antmicro/arty-mpw-tester/doc/arty-mpw-tester.md

# Arty MPW tester

```{image} ../img/arty-mpw-tester.png
:width: 700px
:align: center
```
&nbsp;

The Arty MPW tester is simple expansion board compatible with Digilent Arty A7 development kit. This board connects IO signals from the Xilinx Artix FPGA located on the Arty board to an open hardware Caravel breakout board. The Caravel breakout board allows testing ASIC designs prepared for Multi Project Wafer (MPW) shuttles and fabricated with one of the available open Process Design Kits (PDKs).

The hardware is open and can be found on GitHub:
<https://github.com/antmicro/arty-mpw-tester/>

The following instructions explain how to set up the board for MPW testing.

## Arty MPW tester configuration

Arty MPW tester was designed to give user flexibility in configuration of the tester.\
User can independently configure:

- Power
- FTDI to MPRJ UART connection (enable/disable)
- Source for Caravel-breakout XCLK (internal oscillator / Arty IO42 pin)
- Internal XCLK source (enable/disable)

### Power

The Arty MPW tester can be supplied either from Arty or USB connector.

```{note}
Both power sources are always connected to the dual LDO via protection diodes.
```

#### Fixed/dynamic LDO selection

The Arty MPW tester features dual LDO supplying 1.8V and 3.3V rails.
Each rail can be set to either:

- `FIXED` - supplying fixed 1.8V or 3.3V depending on rail
- `DYNAMIC` - allowing user set LDO voltage using I2C digipot

I2C digipot (`MCP4661-103E/ML`) is used to dynamically adjust 1.8V and 3.3V rail voltages.\
Placing jumper on position `FIXED` on either 1.8V and/or 3.3V rail bypasses digipot and forces LDO into fixed voltage regulation on given rail.

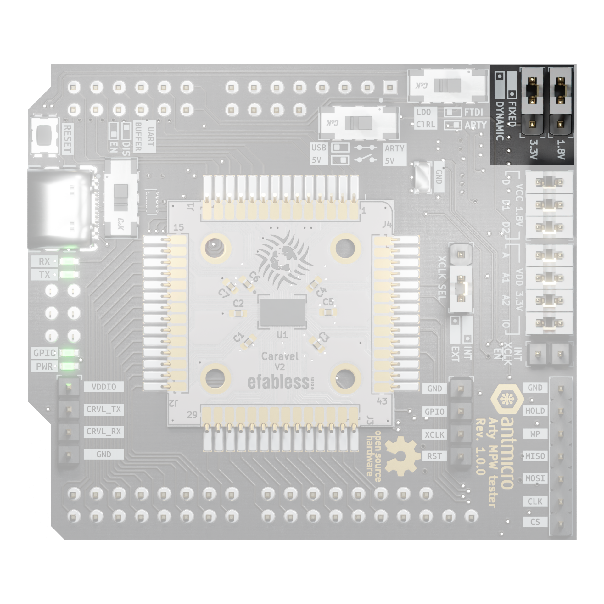
[picture p2: img/arty-mpw-tester-ldo-mode.png]
```{image} ../img/arty-mpw-tester-ldo-mode.png
:width: 500px
:align: center
```

#### Rail EN control

Both 3.3V and 1.8V rails can be enabled separately using `EN1` and `EN2` pins of the LDO.\
`LDO CTRL` switch can be set in two positions:
- `ARTY` - connects the Arty A7 board to the `EN1/2` pins of the dual LDO
- `FTDI` - connects the FTDI to the `EN1/2` pins of the dual LDO

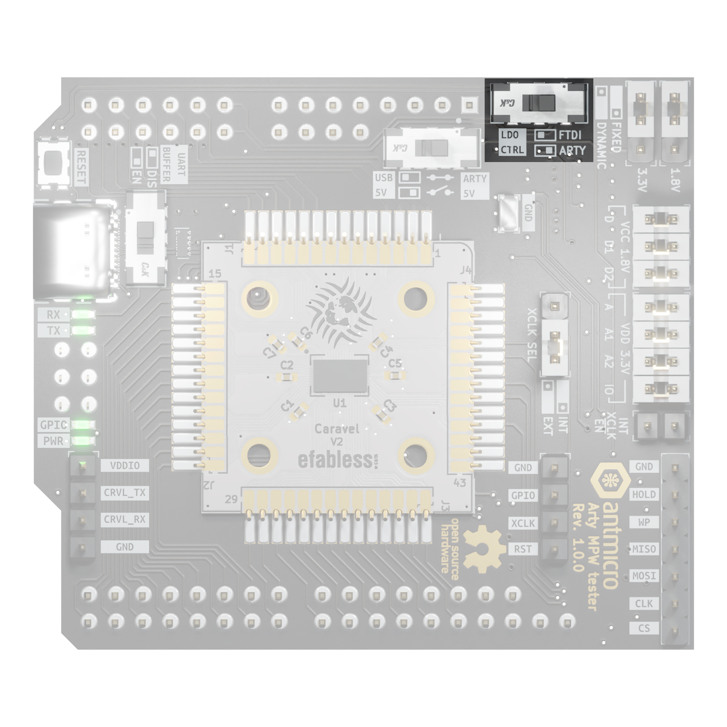
[picture p3: img/arty-mpw-tester-power-ctrl-selector.png]
```{image} ../img/arty-mpw-tester-power-ctrl-selector.png
:width: 500px
:align: center
```

#### Individual rail connections

Each of the power rails routed on Caravel breakout is exposed on `1x2 2.54mm` pin header allowing for selecting which rails are enabled.\
Using this header it is also possible to manually inject voltage into separate rails

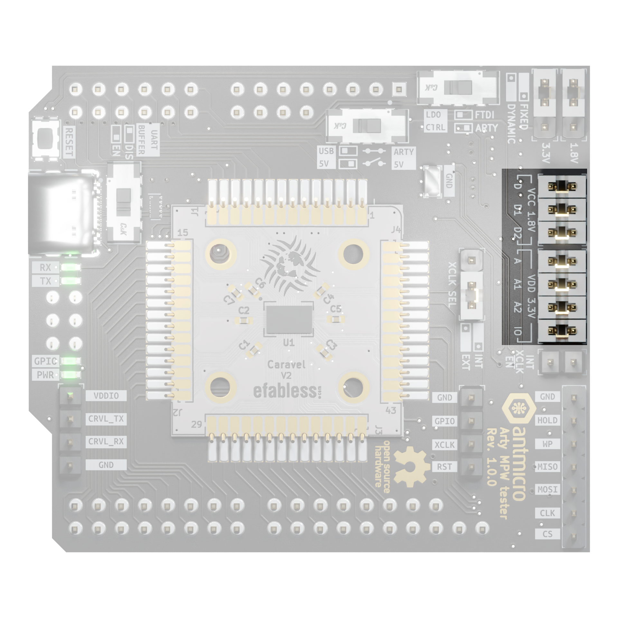
[picture p4: img/arty-mpw-tester-power-rails.png]
 ```{image} ../img/arty-mpw-tester-power-rails.png
:width: 500px
:align: center
```

#### Arty / USB rail connection
```{warning}
This feature should be used only to supply Arty from Arty MPW tester.
```
Switch allowing connection of the 5V USB and 5V Arty rails can be set in two positions:
- `OPEN` - USB 5V and Arty 5V rails are separated
- `CLOSED` - USB 5V and Arty 5V rails are connected, allowing to supply Arty from Arty MPW tester 

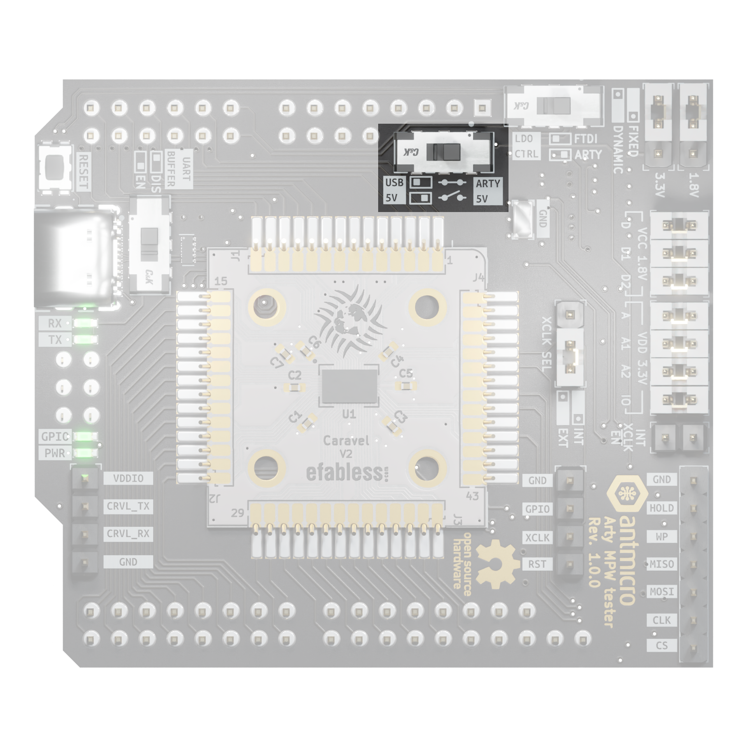
[picture p5: img/arty-mpw-tester-arty-usb-rail-switch.png]
```{image} ../img/arty-mpw-tester-arty-usb-rail-switch.png
:width: 500px
:align: center
```

### USB UART

FTDI used in design (FT230H) can be used in UART and MPSSE mode. By default UART buffers are controlled by FTDI. User can select, by setting `UART BUFFER` switch to either:
- `DIS` - control over UART buffers is retained by FTDI  
- `EN` - forces UART buffers to be enabled

```{note}
For MPSSE mode `UART BUFFER` slide switch should be set to `DIS`.
```

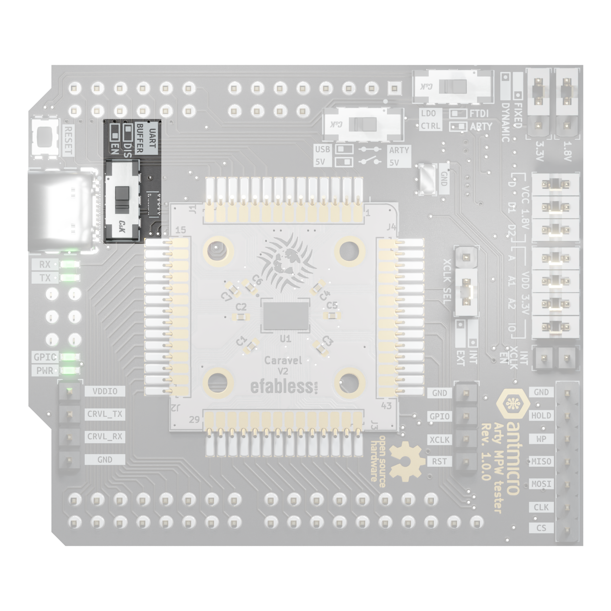
[picture p6: img/arty-mpw-tester-uart-buffer-switch.png]
```{image} ../img/arty-mpw-tester-uart-buffer-switch.png
:width: 500px
:align: center
```

### XCLK

Clock supplied to the Caravel breakout can be sourced in two ways.\
Using `XCLK SEL` header user can switch between:
- `INT` - sourcing XCLK from onboard oscillator
- `EXT` - sourcing XCLK from Arty IO42 pin

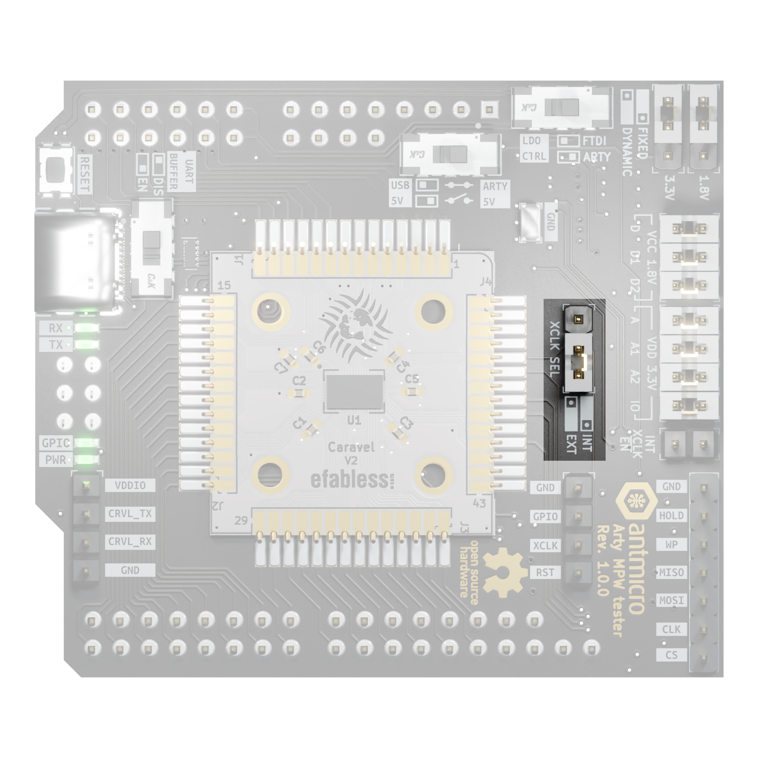
[picture p7: img/arty-mpw-tester-xclk-source-selection.png]
```{image} ../img/arty-mpw-tester-xclk-source-selection.png
:width: 500px
:align: center
```

When `XCLK SEL` is set to `INT` user can enable and disable onboard oscillator using `INT XCLK EN` header:

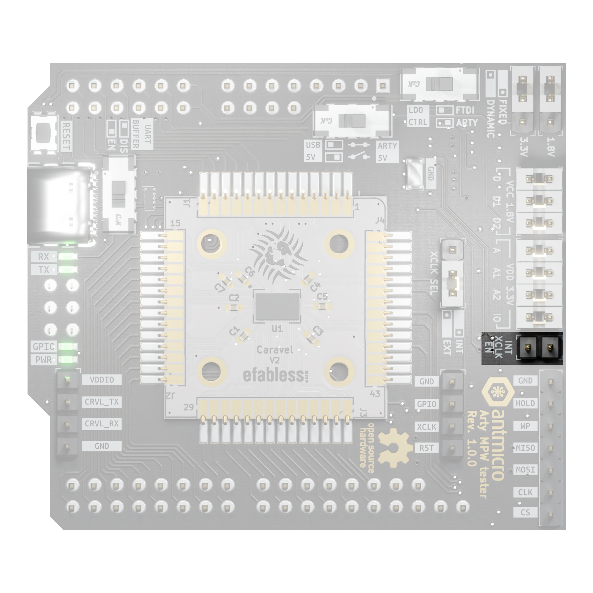
[picture p8: img/arty-mpw-tester-internal-oscillator-ctrl.png]
```{image} ../img/arty-mpw-tester-internal-oscillator-ctrl.png
:width: 500px
:align: center
```

## Default configuration

Before plugging USB to Arty MPW Tester or Arty board make sure that configuration jumpers and switches are set correctly.

Default configuration for the Arty MPW tester is as follows:

| Setting | Slide switch  | Jumper |
|---|---|---|
| 1.8V LDO 	 | 	 | Fixed |
| 3.3V LDO 	 | 	 | Fixed |
| LDO CTRL 	 | ARTY  	 | |
| VCC 1.8V D  	 | 	 | YES |
| VCC 1.8V D1 	 | 	 | YES |
| VCC 1.8V D2 	 | 	 | YES |
| VDD 3.3V A  	 | 	 | YES |
| VDD 3.3V A1 	 | 	 | YES |
| VDD 3.3V A2 	 | 	 | YES |
| VDD 3.3V IO 	 | 	 | YES |
| IN XCLK EN  	 | 	 | NO |
| XCLK SEL 	 | 	 | EXT |
| UART BUFFER 	 | DIS 	 | |
| Arty 5V - USB 5V  | OPEN | |

Picture below presents default configuration for slide switches and jumpers

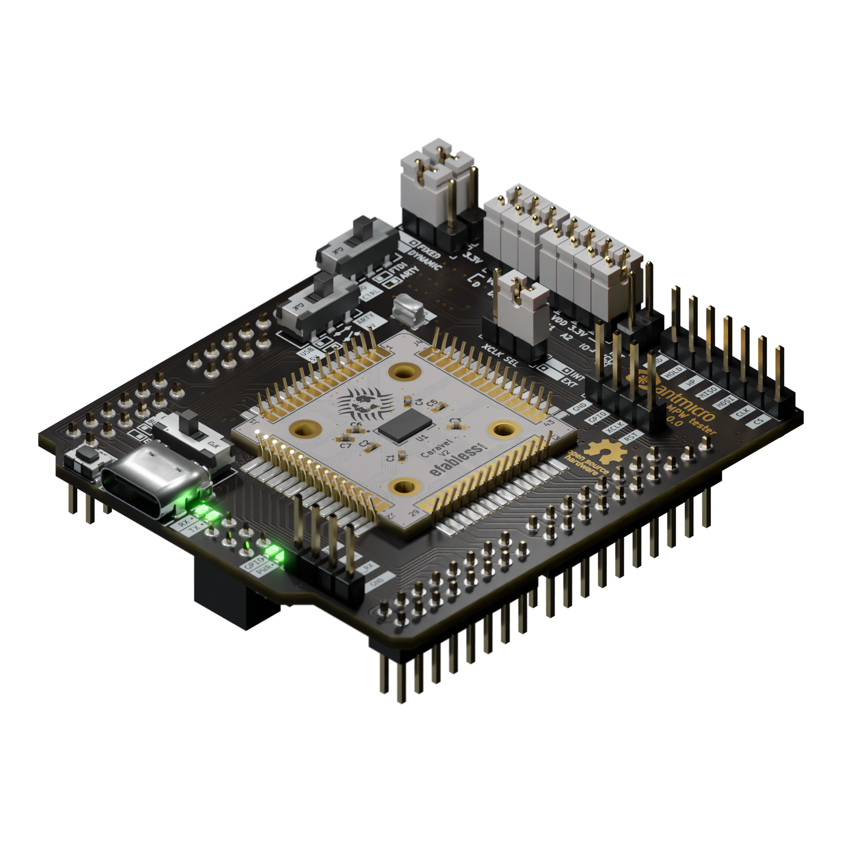
[picture p9: img/arty-mpw-tester-default-configuration.png]
```{image} ../img/arty-mpw-tester-default-configuration.png
:width: 500px
:align: center
```

## Pinouts

### Caravel - Arty interface

| Caravel breakout 	| FPGA Pin 	| ChipKit pin 	| Dedicated function|
|---	|---	|---	|---	|
| IO00 	| R18 	| IO39 	| 	|
| IO01 	| P17 	| IO13 	| SPI MISO 	|
| IO02 	| T18 	| IO38 	| SPI MOSI 	|
| IO03 	| R17 	| IO12 	| SPI CS 	|
| IO04 	| U17 	| IO37 	| SPI  SCK 	|
| IO05 	| U18 	| IO11 	| Caravel RX 	|
| IO06 	| N14 	| IO36 	| Caravel TX 	|
| IO07 	| V17 	| IO10 	| 	|
| IO08 	| N16 	| IO35 	| 	|
| IO09 	| M16 	| IO09 	| 	|
| IO10 	| R16 	| IO34 	| 	|
| IO11 	| N15 	| IO08 	| 	|
| IO12 	| P15 	| IO33 	| 	|
| IO13 	| T16 	| IO07 	| 	|
| IO14 	| R15 	| IO32 	| 	|
| IO15 	| T15 	| IO06 	| 	|
| IO16 	| R13 	| IO31 	| 	|
| IO17 	| T14 	| IO05 	| 	|
| IO18 	| R11 	| IO30 	| 	|
| IO19 	| R12 	| IO04 	| 	|
| IO20 	| R10 	| IO29 	| 	|
| IO21 	| T11 	| IO03 	| 	|
| IO22 	| M13 	| IO28 	| 	|
| IO23 	| P14 	| IO02 	| 	|
| IO24 	| V16 	| IO27 	| 	|
| IO25 	| U16 	| IO01 	| 	|
| IO26 	| U11 	| IO26 	| 	|
| IO27 	| V15 	| IO00 	| 	|
| IO28 	| A3 	| A11 	| 	|
| IO29 	| D5 	| A5 	| 	|
| IO30 	| A4 	| A10 	| 	|
| IO31 	| D7 	| A4 	| 	|
| IO32 	| E5 	| A9 	| 	|
| IO33 	| E7 	| A3 	| 	|
| IO34 	| E6 	| A8 	| 	|
| IO35 	| C7 	| A2 	| 	|
| IO36 	| B6 	| A7 	| 	|
| IO37 	| D8 	| A1 	| 	|
| GPIO 	| M17 	| IO42 	| 	|
| FLASH SO 	| G1 	| MISO 	| 	|
| FLASH SCK 	| F1 	| SCK 	| 	|
| FLASH SI 	| H1 	| MOSI 	| 	|
| FLASH CS 	| C1 	| SS 	| 	|

### Caravel - FTDI interface

| Caravel breakout 	| FTDI 	|
|---	|---	|
| IO01 	| ADBUS2 	|
| IO02 	| ADBUS1 	|
| IO03 	| ADBUS3 	|
| IO04 	| ADBUS0 	|
| IO05 	| ADBUS0 (via buffer) 	|
| IO06 	| ADBUS1 (via buffer) 	|

### Control pins

| Function 	| FTDI 	| FPGA Pin 	| ChipKit pin 	|
|---	|---	|---	|---	|
| LDO EN1 (3.3V) | ACBUS5 	| F5 	| A0 	|
| LDO EN2 (1.8V) 	| ACBUS6 	| B7 	| A6 	|
| Caravel RESET 	| ACBUS1 	| N17 	| IO41 	|
| UART buff EN  	| ACBUS0 	| - 	| - 	|
| XLCK 	| - 	| P18 	| IO40 	|
| DIGIPOT SCL 	| - 	| L18 	| SCL 	|
| DIGIPOT SDA 	| - 	| M18 	| SDA 	|

### MPRJ UART header 

<table>
<tr><td>

| Pin 	| Signal |
|---- |--- |
| 1 | VDDIO |
| 2 | Caravel TX |
| 3 | Caravel RX |
| 4 | GND |

</td><td>

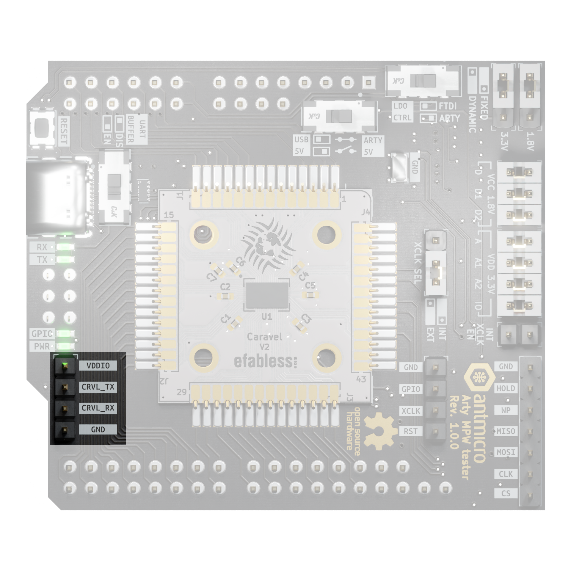
[picture p10: img/arty-mpw-tester-mprj-uart.png]
```{image} ../img/arty-mpw-tester-mprj-uart.png
:width: 400px
:align: center
```

</td></tr> </table>

### SPI flash and Caravel MGMT headers

<table><tr>
<td>

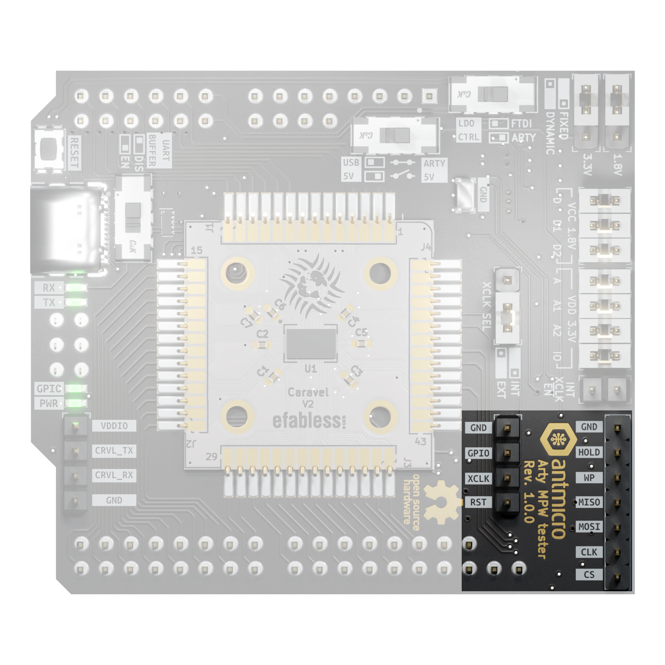
[picture p11: img/arty-mpw-tester-mgmt-headers.png]
```{image} ../img/arty-mpw-tester-mgmt-headers.png
:width: 400px
:align: center
```

</td>
<td>

| Pin 	| Signal  | 
|-----  | ---  |
| 1 |  GND	  | 
| 2 |  GPIO	  | 
| 3 |  XCLK	  | 
| 4 |  RESET  | 

</td>
<td>

| Pin 	| Signal  |
|-----  | ---  |
| 1 |  CS	  |
| 2 |  CLK	  |
| 3 |  MOSI	  |
| 4 |  MISO	  |
| 5 |  CLK	  |
| 6 |  GND	  |

</td>
</tr> </table>
