antmicro/arty-mpw-tester/arty-mpw-tester.kicad_pcb

## KiCad design arty-mpw-tester.kicad_pcb (2022-12-14)

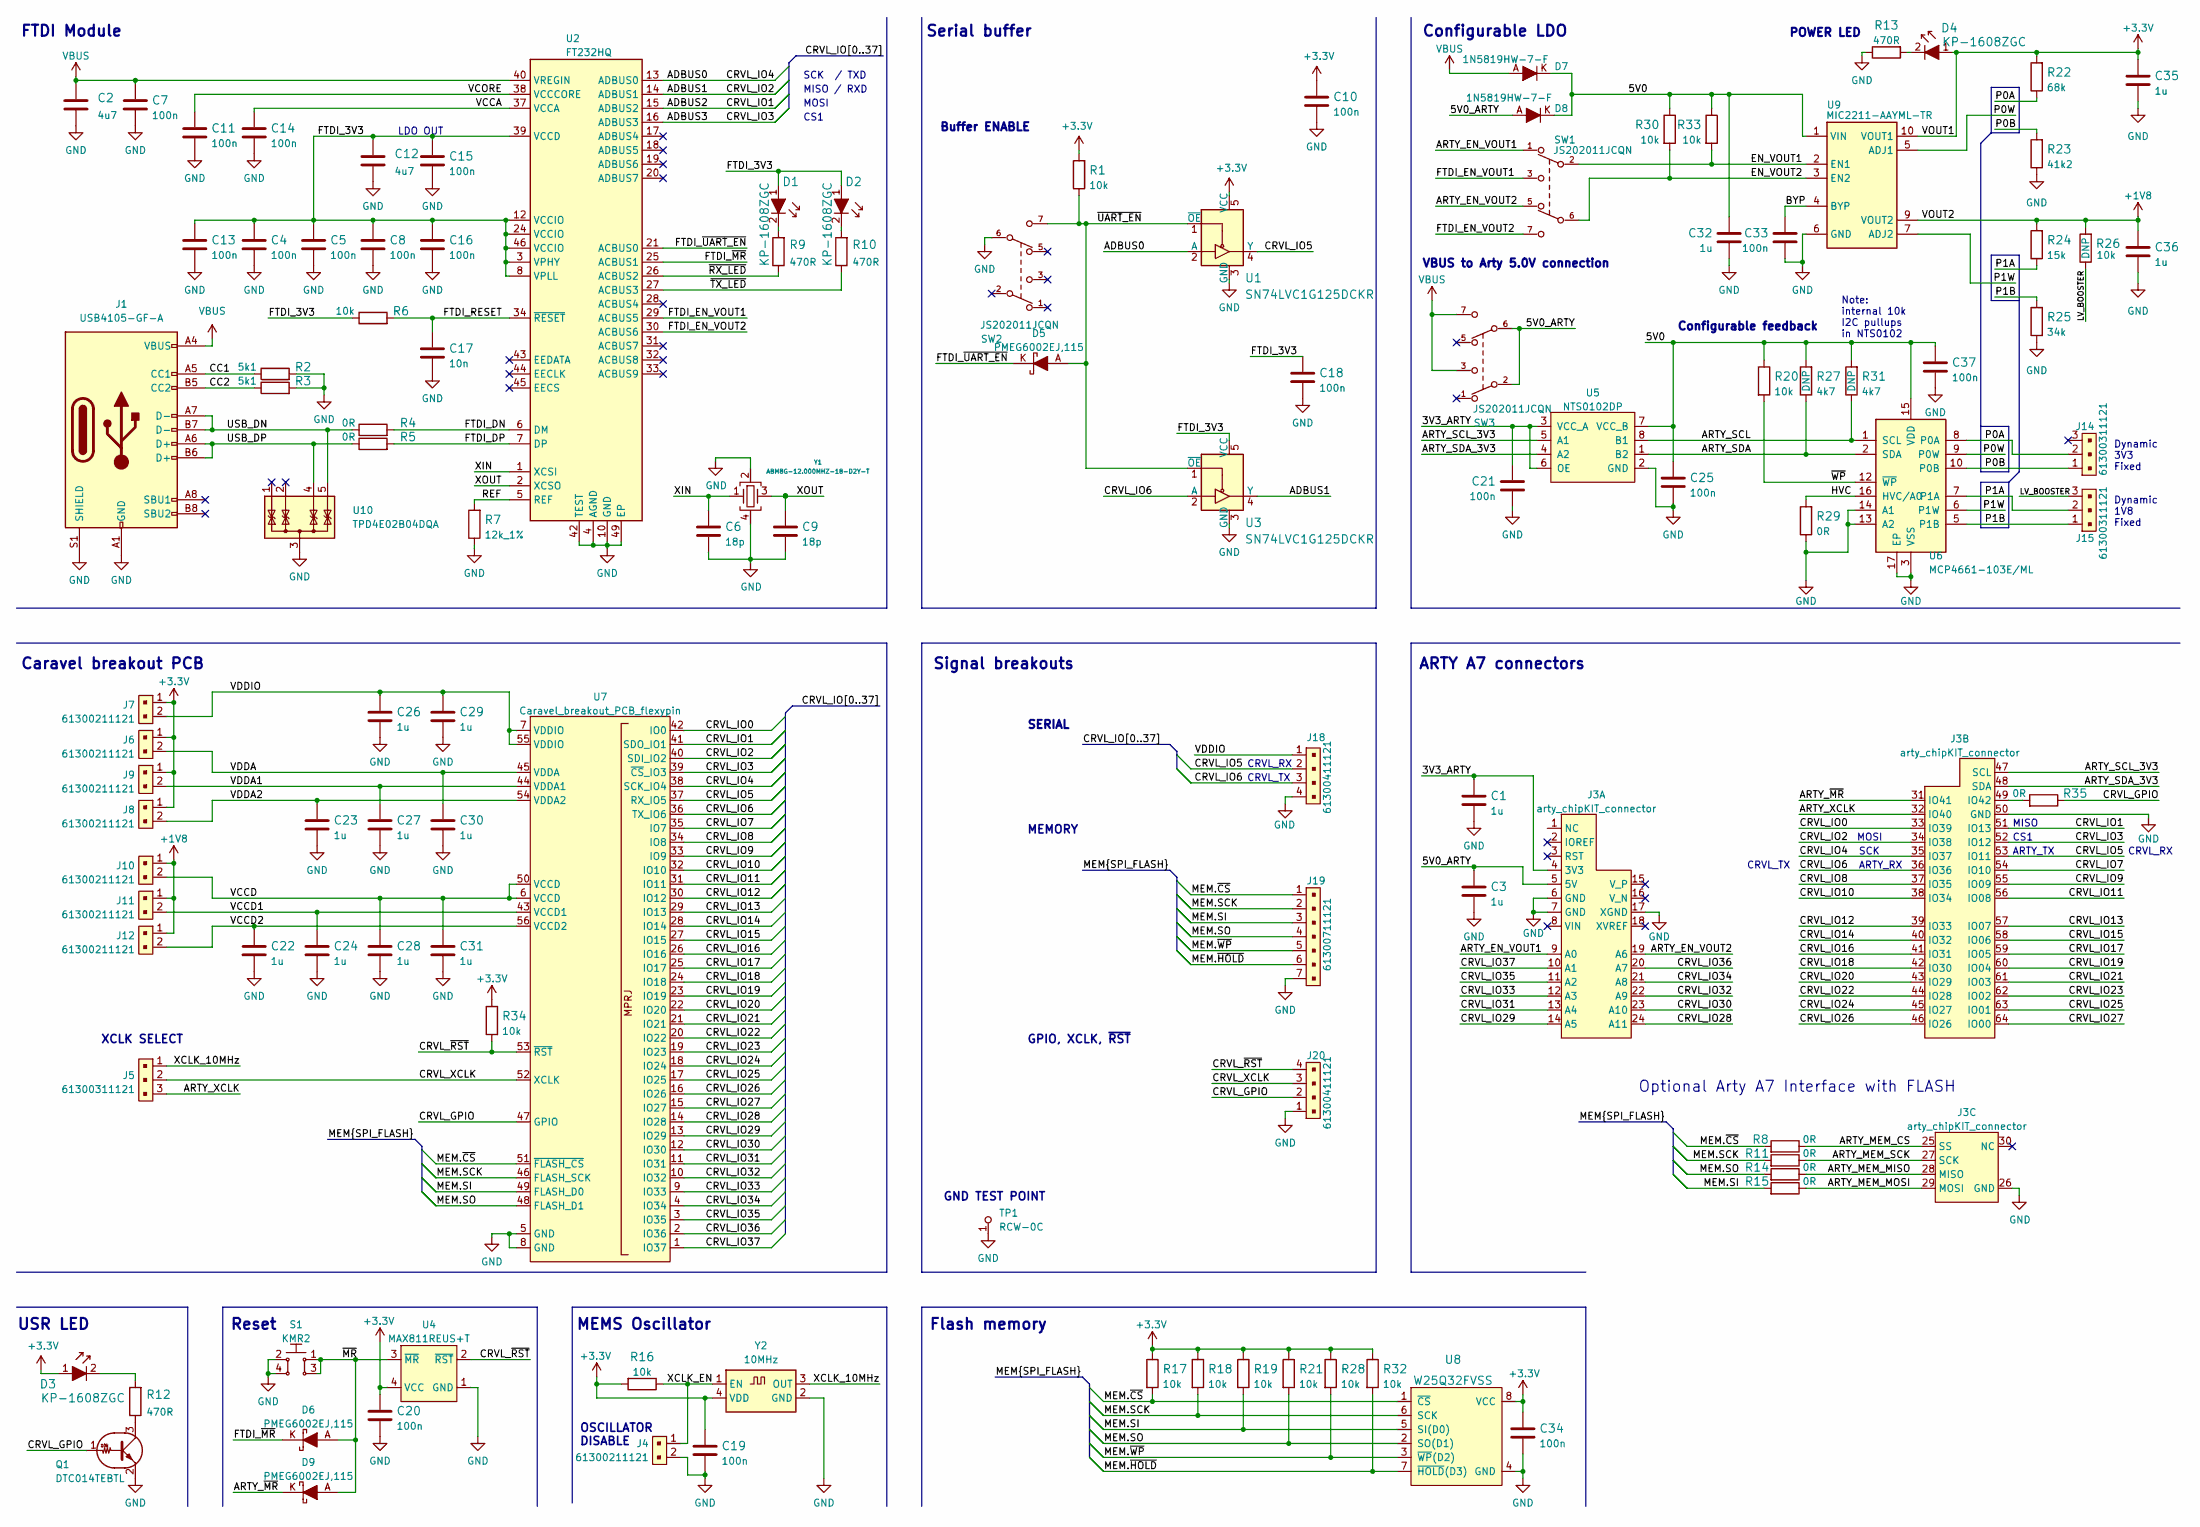
[picture p12: schematic arty-mpw-tester.kicad_sch, Arty MPW Tester]

Parts:
C1, C3, C22, C23, C24, C26, C27, C28, C29, C30, C31, C32, C35, C36: C_1u_0603; 0603-cap; MPN 0603YD105KAT2A
C2, C12: C_4u7_0603; 0603-cap; MPN C1608X5R1V475M080AC
C4, C5, C7, C8, C10, C11, C13, C14, C15, C16, C18, C19, C20, C21, C25, C33, C34, C37: C_100n_0603; 0603-cap; MPN 0603YC104KAZ2A
C6, C9: C_18p_0603; 0603-cap; MPN C0603C180J5GACTU
C17: C_10n_0603; 0603-cap; MPN 06031C103JAT2A
D1, D2, D3, D4: KP-1608ZGC; LED_0603; MPN KP-1608EC
D5, D6, D9: PMEG6002EJ,115; SOD-323F; MPN PMEG6002EJ,115
D7, D8: 1N5819HW-7-F; SOD-123; MPN 1N5819HW-7-F
J1: USB4105-GF-A; GCT_USB4105-GF-A; MPN USB4105-GF-A
J3: arty_chipKIT_connector; ARTY_A7_SHIELD; MPN 9-146281-0
J4, J6, J7, J8, J9, J10, J11, J12: 61300211121; PinHeader_1x2_P2.54_Drill0.9mm; MPN 61300211121
J5, J14, J15: 61300311121; PinHeader_1x3_P2.54_Drill1.1mm; MPN 61300311121
J18, J20: 61300411121; PinHeader_1x4_P2.54mm_Drill1.02mm; MPN 61300411121
J19: 61300711121; MPN 61300711121
Q1: DTC014TEBTL; SOT-416; MPN DTC014TEBTL
R1, R6, R16, R17, R18, R19, R20, R21, R26, R28, R30, R32, R33, R34: R_10k_0603; 0603-res; MPN CR0603-JW-103ELF
R2, R3: R_5k1_0603; 0603-res; MPN CRCW06035K10FKEA
R4, R5: R_0R_0402; 0402-res; MPN ERJ2GE0R00X
R7: R_12k_1%_0603; 0603-res; MPN MCWR06X1202FTL
R8, R11, R14, R15, R29, R35: R_0R_0603; 0603-res; MPN CR0603-J/-000ELF
R9, R10, R12, R13: R_470R_0603; 0603-res; MPN CR0603-JW-471GLF
R22: R_68k_0603; 0603-res; MPN MC0063W0603168K
R23: R_41k2_0603; 0603-res; MPN CRCW060341K2FKEA
R24: R_15k_0603; 0603-res; MPN CR0603-FX-1502ELF
R25: R_34k_0603; 0603-res; MPN ERJ-3EKF3402V
R27, R31: R_4k7_0603; 0603-res; MPN CR0603-FX-4701ELF
S1: KMR2; SW_SPST_4.2x2.8; MPN KMR211NGLFS
SW1, SW2, SW3: JS202011JCQN; MPN JS202011JCQN
TP1: RCW-0C; PROBE_PAD_1206; MPN RCW-0C
U1, U3: SN74LVC1G125DCKR; SOT-353; MPN SN74LVC1G125DCKR
U2: FT232HQ; QFN-48-1EP_8x8mm_P0.5mm_EP6.2x6.2mm_FT232HQ_marking; MPN FT232HQ-TRAY
U4: MAX811REUS+T; SOT-143-4; MPN MAX811REUS+T
U5: NTS0102DP; TSSOP-8_W3mm; MPN NTS0102DP
U6: MCP4661-103E/ML; QFN-16_EP_4x4_Pitch0.65mm; MPN MCP4661103E/ML
U7: Caravel_breakout_PCB_flexypin; caravel-breakout-flexypin
U8: W25Q32FVSS; SOIC127P790X216-8N; MPN W25Q32FVSSIG
U9: MIC2211-AAYML-TR; DFN-10-1EP_3x3mm; MPN MIC2211-AAYML-TR
U10: TPD4E02B04DQA; USON-10_2.5x1.0mm_P0.5mm; MPN TPD4E02B04DQAR
Y1: ABM8G-12.000MHZ-18-D2Y-T; KX-7; MPN ABM8G-12.000MHZ-18-D2Y-T
Y2: ECS-2520MVLC-100-BN-TR; Oscillator_SMD_ECS_2520MV-xxx-xx-4Pin_2.5x2.0mm; MPN ECS-2520MVLC-100-BN-TR

Connections:
+1V8: C36.1, J10.1, J11.1, J12.1, R24.2, R26.2, U9.9 (VOUT2)
+3V3: C10.1, C19.1, C20.1, C34.1, C35.1, D3.1, D4.1, J6.1, J7.1, J8.1, J9.1, R1.2, R16.2, R17.1, R18.1, R19.1, R21.1, R22.2, R28.1, R32.1, R34.1, U1.5 (VCC), U4.4 (VCC), U8.8 (VCC), U9.10 (VOUT1), Y2.4 (VDD)
/3V3_ARTY: C1.1, C21.1, J3.4 (3V3), U5.3 (VCC_A), U5.6 (OE)
/5V0: C25.1, C32.1, C37.1, D7.K, D8.K, R20.1, R27.2, R30.1, R31.2, R33.1, U5.7 (VCC_B), U6.15 (VDD), U9.1 (VIN)
/5V0_ARTY: C3.1, D8.A, J3.5 (5V), SW3.2 (1_C), SW3.6 (2_C)
/ARTY_EN_VOUT1: J3.9 (A0), SW1.1
/ARTY_EN_VOUT2: J3.19 (A6), SW1.5
/ARTY_MEM_CS: J3.25 (SS), R8.1
/ARTY_MEM_MISO: J3.28 (MISO), R14.1
/ARTY_MEM_MOSI: J3.29 (MOSI), R15.1
/ARTY_MEM_SCK: J3.27 (SCK), R11.1
/ARTY_SCL: R31.1, U5.8 (B1), U6.1 (SCL)
/ARTY_SCL_3V3: J3.47 (SCL), U5.5 (A1)
/ARTY_SDA: R27.1, U5.1 (B2), U6.2 (SDA)
/ARTY_SDA_3V3: J3.48 (SDA), U5.4 (A2)
/ARTY_XCLK: J3.32 (IO40), J5.3
/ARTY_~MR: D9.K, J3.31 (IO41)
/BYP: C33.1, U9.4 (BYP)
/CC1: J1.A5 (CC1), R2.1
/CC2: J1.B5 (CC2), R3.1
/CRVL_GPIO: J20.2, Q1.1 (B), R35.1, U7.47 (GPIO)
/CRVL_IO0: J3.33 (IO39), U7.42 (IO0)
/CRVL_IO1: J3.51 (IO13), U2.15 (ADBUS2), U7.41 (SDO_IO1)
/CRVL_IO2: J3.34 (IO38), U2.14 (ADBUS1), U3.4 (Y), U7.40 (SDI_IO2)
/CRVL_IO3: J3.52 (IO12), U2.16 (ADBUS3), U7.39 (~CS_IO3)
/CRVL_IO4: J3.35 (IO37), U1.2 (A), U2.13 (ADBUS0), U7.38 (SCK_IO4)
/CRVL_IO5: J3.53 (IO11), J18.2, U1.4 (Y), U7.37 (RX_IO5)
/CRVL_IO6: J3.36 (IO36), J18.3, U3.2 (A), U7.36 (TX_IO6)
/CRVL_IO7: J3.54 (IO10), U7.35 (IO7)
/CRVL_IO8: J3.37 (IO35), U7.34 (IO8)
/CRVL_IO9: J3.55 (IO09), U7.33 (IO9)
/CRVL_IO10: J3.38 (IO34), U7.32 (IO10)
/CRVL_IO11: J3.56 (IO08), U7.31 (IO11)
/CRVL_IO12: J3.39 (IO33), U7.30 (IO12)
/CRVL_IO13: J3.57 (IO07), U7.29 (IO13)
/CRVL_IO14: J3.40 (IO32), U7.28 (IO14)
/CRVL_IO15: J3.58 (IO06), U7.27 (IO15)
/CRVL_IO16: J3.41 (IO31), U7.26 (IO16)
/CRVL_IO17: J3.59 (IO05), U7.25 (IO17)
/CRVL_IO18: J3.42 (IO30), U7.24 (IO18)
/CRVL_IO19: J3.60 (IO04), U7.23 (IO19)
/CRVL_IO20: J3.43 (IO29), U7.22 (IO20)
/CRVL_IO21: J3.61 (IO03), U7.21 (IO21)
/CRVL_IO22: J3.44 (IO28), U7.20 (IO22)
/CRVL_IO23: J3.62 (IO02), U7.19 (IO23)
/CRVL_IO24: J3.45 (IO27), U7.18 (IO24)
/CRVL_IO25: J3.63 (IO01), U7.17 (IO25)
/CRVL_IO26: J3.46 (IO26), U7.16 (IO26)
/CRVL_IO27: J3.64 (IO00), U7.15 (IO27)
/CRVL_IO28: J3.24 (A11), U7.14 (IO28)
/CRVL_IO29: J3.14 (A5), U7.13 (IO29)
/CRVL_IO30: J3.23 (A10), U7.12 (IO30)
/CRVL_IO31: J3.13 (A4), U7.11 (IO31)
/CRVL_IO32: J3.22 (A9), U7.10 (IO32)
/CRVL_IO33: J3.12 (A3), U7.9 (IO33)
/CRVL_IO34: J3.21 (A8), U7.4 (IO34)
/CRVL_IO35: J3.11 (A2), U7.3 (IO35)
/CRVL_IO36: J3.20 (A7), U7.2 (IO36)
/CRVL_IO37: J3.10 (A1), U7.1 (IO37)
/CRVL_XCLK: J5.2, J20.3, U7.52 (XCLK)
/CRVL_~RST: J20.4, R34.2, U4.2 (~RST), U7.53 (~RST)
/EN_VOUT1: R33.2, SW1.2 (1_C), U9.2 (EN1)
/EN_VOUT2: R30.2, SW1.6 (2_C), U9.3 (EN2)
/FTDI_3V3: C4.1, C5.1, C8.1, C12.1, C13.1, C15.1, C16.1, C18.1, D1.1, D2.1, R6.1, U2.3 (VPHY), U2.8 (VPLL), U2.12 (VCCIO), U2.24 (VCCIO), U2.39 (VCCD), U2.46 (VCCIO), U3.5 (VCC)
/FTDI_DN: R4.2, U2.6 (DM)
/FTDI_DP: R5.2, U2.7 (DP)
/FTDI_EN_VOUT1: SW1.3, U2.29 (ACBUS5)
/FTDI_EN_VOUT2: SW1.7, U2.30 (ACBUS6)
/FTDI_RESET: C17.1, R6.2, U2.34 (~RESET)
/FTDI_~MR: D6.K, U2.25 (ACBUS1)
/FTDI_~UART_EN: D5.K, U2.21 (ACBUS0)
/HVC: R29.2, U6.16 (HVC/A0)
/LV_BOOSTER: J15.3, R26.1
/MEM.SCK: J19.2, R11.2, R18.2, U7.46 (FLASH_SCK), U8.6 (SCK)
/MEM.SI: J19.3, R15.2, R19.2, U7.49 (FLASH_D0), U8.5 (SI(D0))
/MEM.SO: J19.4, R14.2, R21.2, U7.48 (FLASH_D1), U8.2 (SO(D1))
/MEM.~CS: J19.1, R8.2, R17.2, U7.51 (~FLASH_CS), U8.1 (~CS)
/MEM.~HOLD: J19.6, R32.2, U8.7 (~HOLD(D3))
/MEM.~WP: J19.5, R28.2, U8.3 (~WP(D2))
/P0A: J14.2, R22.1, U6.8 (P0A)
/P0B: J14.1, R23.2, U6.10 (P0B)
/P0W: U6.9 (P0W), U9.5 (ADJ1)
/P1A: J15.2, R24.1, U6.7 (P1A)
/P1B: J15.1, R25.2, U6.5 (P1B)
/P1W: U6.6 (P1W), U9.7 (ADJ2)
/REF: R7.2, U2.5 (REF)
/USB_DN: J1.A7 (D-), J1.B7 (D-), R4.1, U10.5 (IO4), U10.6 (NC)
/USB_DP: J1.A6 (D+), J1.B6 (D+), R5.1, U10.4 (IO3), U10.7 (NC)
/VCCA: C14.1, U2.37 (VCCA)
/VCCD: C28.1, C31.1, J10.2, U7.6 (VCCD), U7.50 (VCCD)
/VCCD1: C24.1, J11.2, U7.43 (VCCD1)
/VCCD2: C22.1, J12.2, U7.56 (VCCD2)
/VCORE: C11.1, U2.38 (VCCCORE)
/VDDA: C30.1, J6.2, U7.45 (VDDA)
/VDDA1: C27.1, J9.2, U7.44 (VDDA1)
/VDDA2: C23.1, J8.2, U7.54 (VDDA2)
/VDDIO: C26.1, C29.1, J7.2, J18.1, U7.7 (VDDIO), U7.55 (VDDIO)
/XCLK_10MHz: J5.1, Y2.3 (OUT)
/XCLK_EN: J4.1, R16.1, Y2.1 (EN)
/XIN: C6.1, U2.1 (XCSI), Y1.1
/XOUT: C9.1, U2.2 (XCSO), Y1.3
/~MR: D6.A, D9.A, S1.1, S1.3, U4.3 (~MR)
/~RX_LED: R9.1, U2.26 (ACBUS2)
/~TX_LED: R10.1, U2.27 (ACBUS3)
/~UART_EN: D5.A, R1.1, SW2.7, U1.1 (~OE), U3.1 (~OE)
/~WP: R20.2, U6.12 (~WP)
AGND: C1.2, C2.2, C3.2, C4.2, C5.2, C6.2, C7.2, C8.2, C9.2, C10.2, C11.2, C12.2, C13.2, C14.2, C15.2, C16.2, C17.2, C18.2, C19.2, C20.2, C21.2, C22.2, C23.2, C24.2, C25.2, C26.2, C27.2, C28.2, C29.2, C30.2, C31.2, C32.2, C33.2, C34.2, C35.2, C36.2, C37.2, J1.A1 (GND), J1.A12 (GND), J1.B1 (GND), J1.B12 (GND), J1.S1 (SHIELD), J3.6 (GND), J3.7 (GND), J3.17 (XGND), J3.26 (GND), J3.50 (GND), J4.2, J18.4, J19.7, J20.1, Q1.2 (E), R2.2, R3.2, R7.1, R13.1, R23.1, R25.1, R29.1, S1.2, S1.4, SW2.6 (2_C), TP1.1, U1.3 (GND), U2.4 (AGND), U2.9 (AGND), U2.10 (GND), U2.11 (GND), U2.22 (GND), U2.23 (GND), U2.35 (GND), U2.36 (GND), U2.41 (AGND), U2.42 (TEST), U2.47 (GND), U2.48 (GND), U2.49 (EP), U3.3 (GND), U4.1 (GND), U5.2 (GND), U6.3 (VSS), U6.4 (VSS), U6.13 (A2), U6.14 (A1), U6.17 (EP), U7.5 (GND), U7.8 (GND), U8.4 (GND), U9.6 (GND), U9.11 (EP), U10.3 (G), U10.8 (G), Y1.2, Y1.4, Y2.2 (GND)
unnamed: D1.2, R9.2
unnamed: D2.2, R10.2
unnamed: D3.2, R12.2
unnamed: D4.2, R13.2
unnamed: J3.49 (IO42), R35.2
unnamed: Q1.3 (C), R12.1
VBUS: C2.1, C7.1, D7.A, J1.A4 (VBUS), J1.A9 (VBUS), J1.B4 (VBUS), J1.B9 (VBUS), SW3.3, SW3.7, U2.40 (VREGIN)

Notes on the sheet:
SERIAL
CRVL_RX
Dynamic 3V3 Fixed
Configurable LDO
GND TEST POINT
Note: internal 10k I2C pullups in NTS0102
GPIO, XCLK, ~{RST}
LDO OUT
Flash memory
MEMS Oscillator
ARTY A7 connectors
Dynamic 1V8 Fixed
Serial buffer
SCK
Caravel breakout PCB
CRVL_TX
POWER LED
ARTY_TX
OSCILLATOR DISABLE
Configurable feedback
ARTY_RX
SCK / TXD
Reset
FTDI Module
Signal breakouts
MOSI
XCLK SELECT
MISO / RXD
Optional Arty A7 Interface with FLASH
MEMORY
VBUS to Arty 5.0V connection
MISO
Buffer ENABLE
USR LED
CS1

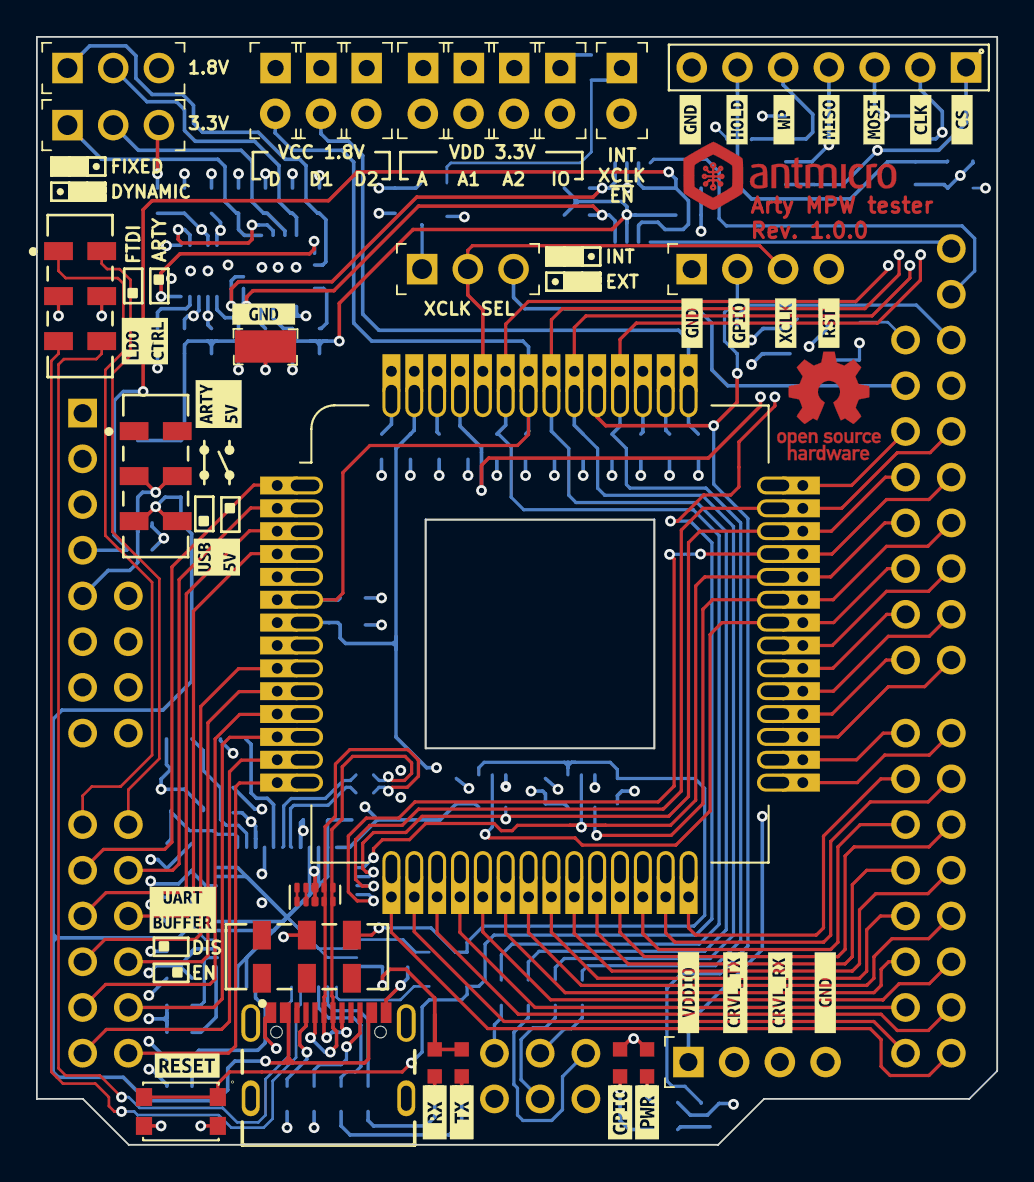
[picture p13: board arty-mpw-tester.kicad_pcb from above]

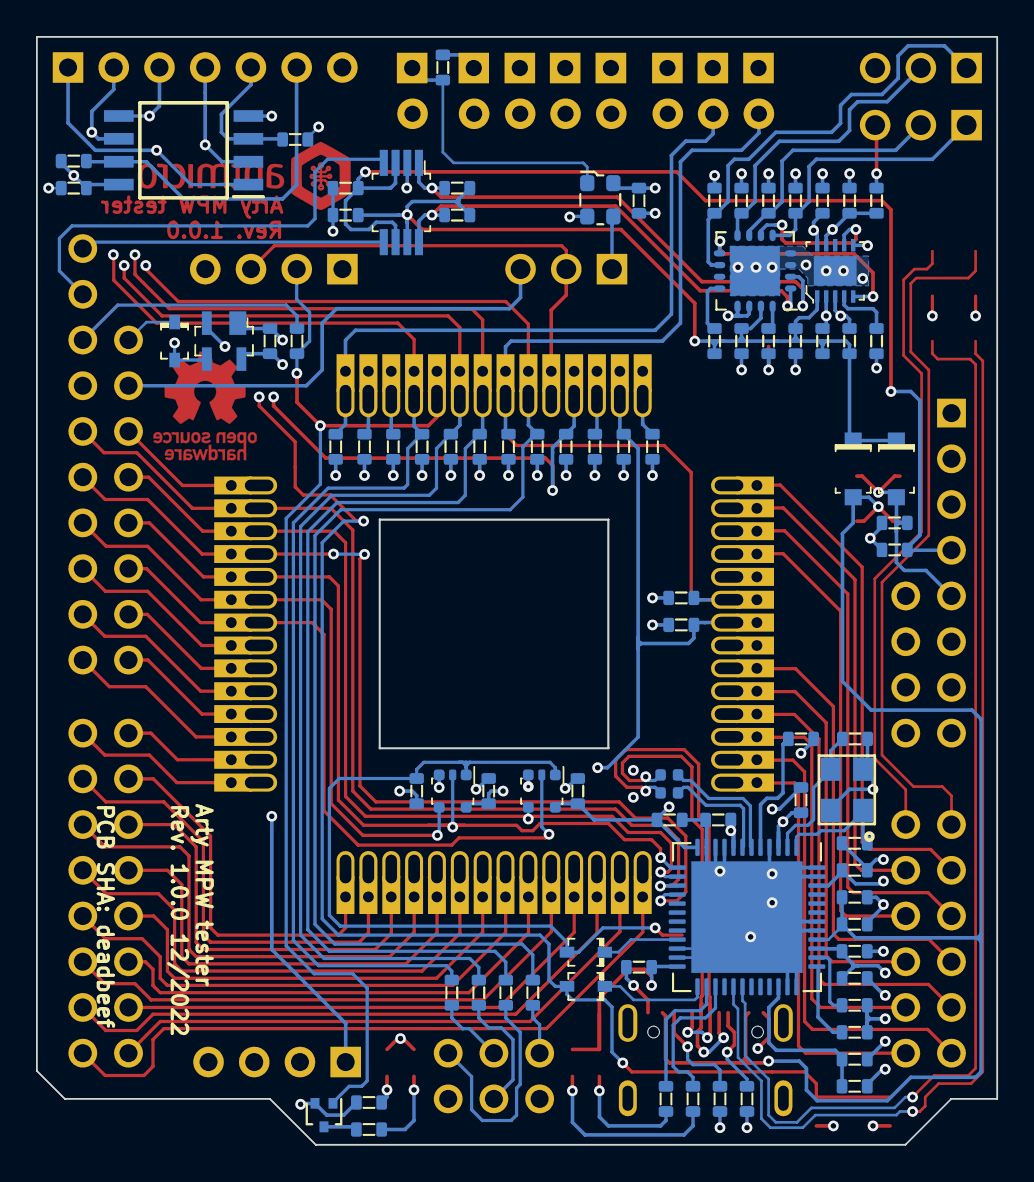
[picture p14: board arty-mpw-tester.kicad_pcb from below]

Board: 4 copper layers, 53.3 x 61.5 mm, 140 parts (89 on the bottom side), 114 nets.

Other parts of the board:
kibuzzard-638F9F3B: G***; kibuzzard-638F9F3B
kibuzzard-638F9F6E: G***; kibuzzard-638F9F6E
kibuzzard-638F9F40: G***; kibuzzard-638F9F40
kibuzzard-638F9F51: G***; kibuzzard-638F9F51
kibuzzard-638F9F83: G***; kibuzzard-638F9F83
kibuzzard-638FA1CB: G***; kibuzzard-638FA1CB
kibuzzard-63938A8C: G***; kibuzzard-63938A8C
kibuzzard-63938B4C: G***; kibuzzard-63938B4C
kibuzzard-639040B1: G***; kibuzzard-639040B1
kibuzzard-639040B6: G***; kibuzzard-639040B6
kibuzzard-639040BB: G***; kibuzzard-639040BB
kibuzzard-639040CA: G***; kibuzzard-639040CA
kibuzzard-639091D1: G***; kibuzzard-639091D1
kibuzzard-639091D4: G***; kibuzzard-639091D4
kibuzzard-639091D8: G***; kibuzzard-639091D8
kibuzzard-639091DC: G***; kibuzzard-639091DC
kibuzzard-639390A2: G***; kibuzzard-639390A2
kibuzzard-6390923A: G***; kibuzzard-6390923A
kibuzzard-6390923D: G***; kibuzzard-6390923D
kibuzzard-6393906F: G***; kibuzzard-6393906F
kibuzzard-63909224: G***; kibuzzard-63909224
kibuzzard-63909228: G***; kibuzzard-63909228
kibuzzard-63909232: G***; kibuzzard-63909232
kibuzzard-63909236: G***; kibuzzard-63909236
kibuzzard-63909242: G***; kibuzzard-63909242
