antmicro/arty-mpw-tester/(commit log)

2022-12-02 Add FTDI and USB. Improve Caravel breakout symbol
    [mpw-tester-arty-expansion.kicad_sch]
2022-12-02 Add voltage selection, add current measurement points add UART buffer
    [mpw-tester-arty-expansion.kicad_sch]
2022-12-02 Add LDOs and 10MHz oscillator
    [mpw-tester-arty-expansion.kicad_sch]
2022-12-02 Add remaining ICs, divide schematic into blocks. Add Arty A7 hat outline
    [mpw-tester-arty-expansion.kicad_pcb, mpw-tester-arty-expansion.kicad_sch]
2022-12-05 Unify labels
    [mpw-tester-arty-expansion.kicad_sch]
2022-12-05 Add decoupling to the Caravel
    [mpw-tester-arty-expansion.kicad_sch]
2022-12-05 Improve FTDI symbol. Udpate LDO EN signal name scheme
    [mpw-tester-arty-expansion.kicad_sch]
2022-12-05 Simplify power section. Add header to each Caravel power rail
    [mpw-tester-arty-expansion.kicad_sch]
2022-12-05 Update MCP4661 symbol
    [mpw-tester-arty-expansion.kicad_sch]
2022-12-05 Cleanup net names
    [mpw-tester-arty-expansion.kicad_sch]
2022-12-05 Cleanup configurable LDO section
    [mpw-tester-arty-expansion.kicad_sch]
2022-12-05 Replace 0603 and 0805 100n and 18p capacitors with 0402
    [mpw-tester-arty-expansion.kicad_sch]
2022-12-05 Inital placement
    [mpw-tester-arty-expansion.kicad_pcb]
2022-12-06 Improve placement, aling pin headers
    [mpw-tester-arty-expansion.kicad_pcb]
2022-12-06 Start connecting Caravel to Arty
    [mpw-tester-arty-expansion.kicad_sch]
2022-12-06 Fix signals label on U3. Power U3 from FTDI 3V3
    [mpw-tester-arty-expansion.kicad_sch]
2022-12-06 Connect Caravel after rotating it on PCB. Adjust component placement
    [mpw-tester-arty-expansion.kicad_pcb, mpw-tester-arty-expansion.kicad_sch]
2022-12-06 Add labels
    [mpw-tester-arty-expansion.kicad_pcb]
2022-12-07 Remove dimmensions used to center the Caravel module
    [mpw-tester-arty-expansion.kicad_pcb]
2022-12-07 Use appropriate resistor values in LDO feedback, simplify power section
    [mpw-tester-arty-expansion.kicad_sch]
2022-12-07 Import changes to PCB, adjust placement
    [mpw-tester-arty-expansion.kicad_pcb, mpw-tester-arty-expansion.kicad_sch]
2022-12-07 Change R/C components to 0603 package. Change I2C translator package
    [mpw-tester-arty-expansion.kicad_sch]
2022-12-07 Replace remaining 0402 components with 0603 except resistors on USB_D lines
    [mpw-tester-arty-expansion.kicad_sch]
2022-12-07 Import changes to PCB. Adjust placement. Partial layout
    [mpw-tester-arty-expansion.kicad_pcb]
2022-12-07 Improve placement of the pin headers
    [mpw-tester-arty-expansion.kicad_pcb]
2022-12-07 Connect remaining singals to Arty
    [mpw-tester-arty-expansion.kicad_sch]
2022-12-07 Start power section layout. Adjust J6-J12 position on schematic to resolve crosses on PCB
    [mpw-tester-arty-expansion.kicad_pcb, mpw-tester-arty-expansion.kicad_sch]
2022-12-08 Change page size to A3, add diodes to buffer UART_EN and MR signals
    [mpw-tester-arty-expansion.kicad_sch]
2022-12-08 Fix label names
    [mpw-tester-arty-expansion.kicad_sch]
2022-12-08 Import changes to PCB, place new diodes
    [mpw-tester-arty-expansion.kicad_pcb]
2022-12-08 Improve readability of the MR and UART_EN connections
    [mpw-tester-arty-expansion.kicad_sch]
2022-12-08 Add LDO EN signals switch between ARTY and FTDI
    [mpw-tester-arty-expansion.kicad_sch]
2022-12-08 Add PWR CTRL switch to the PCB, place UART selector in TMP place
    [mpw-tester-arty-expansion.kicad_pcb]
2022-12-08 correct too small footprint of FTDI, reconnect nearby tracks
    [mpw-tester-arty-expansion.kicad_pcb, mpw-tester-arty-expansion.kicad_sch]
2022-12-08 Remove EP vias from FT232 footprint
    [mpw-tester-arty-expansion.kicad_pcb]
2022-12-09 Update FT232H footprint
    [mpw-tester-arty-expansion.kicad_pcb, mpw-tester-arty-expansion.kicad_sch]
2022-12-09 Swap Arty_EN_VOUT 1 and 2. Continue layout
    [mpw-tester-arty-expansion.kicad_pcb, mpw-tester-arty-expansion.kicad_sch]
2022-12-09 Finish routing of the board without UART_EN header
    [mpw-tester-arty-expansion.kicad_pcb]
2022-12-09 Add slide switches for Arty powered from USB and UART buffer ctrl
    [mpw-tester-arty-expansion.kicad_pcb, mpw-tester-arty-expansion.kicad_sch]
2022-12-09 Add USB TVS, finish layout, resolve DRC
    [mpw-tester-arty-expansion.kicad_pcb, mpw-tester-arty-expansion.kicad_sch]
2022-12-12 Update footprints, add missing 3D models
2022-12-12 Fix Arty symbol, add EP pin to MIC221 and MCP4661 symbols
    [mpw-tester-arty-expansion.kicad_sch]
2022-12-12 Update footprints, add courtyard to Arty connectors, minor layout optimizations
    [mpw-tester-arty-expansion.kicad_pcb]
2022-12-12 Update Caravel footprint
    [mpw-tester-arty-expansion.kicad_pcb]
2022-12-12 Add logos to the schematic
    [mpw-tester-arty-expansion.kicad_sch]
2022-12-12 Add logos and marking
    [mpw-tester-arty-expansion.kicad_pcb]
2022-12-12 correct MPN of arty connector
    [mpw-tester-arty-expansion.kicad_sch]
2022-12-12 Add PCB marking, fix footprint types, update layout
    [mpw-tester-arty-expansion.kicad_pcb]
2022-12-12 correct arty connector symbol in local lib
2022-12-12 Exclude silkscreen violations
    [mpw-tester-arty-expansion.kicad_pcb, mpw-tester-arty-expansion.kicad_sch]
2022-12-12 Add optional connection between Arty IO42 and Caravel GPIO
    [mpw-tester-arty-expansion.kicad_pcb, mpw-tester-arty-expansion.kicad_sch]
2022-12-12 Added model of Arty A7 fof visualization. Corrected Antmicro logo
    [mpw-tester-arty-expansion.kicad_pcb, mpw-tester-arty-expansion.kicad_sch]
2022-12-12 Unify designator and values, hide them
    [mpw-tester-arty-expansion.kicad_pcb]
2022-12-12 Update PCB name, bump revision to 1.0.0
    [mpw-tester-arty-expansion.kicad_pcb, mpw-tester-arty-expansion.kicad_sch]
2022-12-12 Removed Arty A7 model
    [mpw-tester-arty-expansion.kicad_pcb, mpw-tester-arty-expansion.kicad_sch]
2022-12-12 Corrected deadbeef signage
    [mpw-tester-arty-expansion.kicad_pcb]
2022-12-12 Fix signage
    [mpw-tester-arty-expansion.kicad_pcb]
2022-12-12 Update naming convention
    [arty-mpw-tester.kicad_pcb, arty-mpw-tester.kicad_sch]
2022-12-14 Update caravel-breakout footprint with more detailed 3D model and flexypins
    [arty-mpw-tester.kicad_pcb, arty-mpw-tester.kicad_sch]
2022-12-14 Rotate slide switches so 3D models match default configuration. Update Arty A7 shield connector side
    [arty-mpw-tester.kicad_pcb, arty-mpw-tester.kicad_sch]
2022-12-14 Add jumper models to the PCB
    [arty-mpw-tester.kicad_pcb]
2022-12-27 Update PCB img
2022-12-27 Add initial info about configuration, power and xclk
2022-12-27 Clarify note about connecting 5V Atry an 5V USB rails
2022-12-27 DOCS:Add content to USB UART and XCLK section. Update Power section.
2022-12-27 Add pinouts to UART, SPI flash and Caravel MGMT headers
2023-01-06 Add schematic PDF
2023-10-13 Introduce project standardization
    [arty-mpw-tester.kicad_sch]
2023-10-13 [#50304] Add OHP assets and schematic PDF
2023-10-16 Stop ignoring csv
    [stackup.csv]
2024-07-11 [#62395] Perform kmake DNP
    [arty-mpw-tester.kicad_sch]
2024-07-11 [#62395] Perform kmake globlib
    [arty-mpw-tester.kicad_sch]
2024-07-11 [#62395] Update symbols D,J,N,Q,SW,U,Y references
    [arty-mpw-tester.kicad_sch]
2024-07-11 [#62395] Update R,C and allign schematic
    [arty-mpw-tester.kicad_sch]
2024-07-16 [#62395] Update J2
    [arty-mpw-tester.kicad_sch]
2024-07-16 [#62395] Update C, D footprints
2024-07-16 [#62395] Update J, N footprints
    [arty-mpw-tester.kicad_sch]
2024-07-16 [#62395] Update Q,R,S footprints
2024-07-16 [#62395] Update U, Y footprints
2024-07-16 [#62395] Clean ERC
    [arty-mpw-tester.kicad_sch]
2024-07-16 [#62395] Add PCB SHA
2024-07-18 [#62395] Update J4 to M20-9990246
    [arty-mpw-tester.kicad_sch]
2024-07-18 [#62395] Fix oshw logo coliding silkscreen
2024-07-18 [#62395] Bump rev to 1.1.0
    [arty-mpw-tester.kicad_sch]
2024-07-18 [#62395] Update GND and 3V3 symbols
    [arty-mpw-tester.kicad_sch]
2024-07-24 [#62395] Update J6
    [arty-mpw-tester.kicad_sch]
2024-07-24 [#62395] Update J2 footprint & fix DRC
    [arty-mpw-tester.kicad_sch]
2024-07-25 [#62395] Schematic: Minor fixes
    [arty-mpw-tester.kicad_sch]
2024-07-26 [#62395] Add SPI_FLASH bus alias
    [arty-mpw-tester.kicad_sch]
2024-07-26 [#62395] PCB: Prevent acid traps & update bot rev
2024-07-30 [#62395] Update schematic.pdf
2024-08-16 [#62395] Update Pin Headers from main comp lib
    [arty-mpw-tester.kicad_sch]
2025-11-19 [#82385] Project refresh 81589
    [arty-mpw-tester.kicad_sch]
2025-11-19 Fix DNP
    [arty-mpw-tester.kicad_sch]
2025-11-19 Cleanup files
    [stackup.csv]
