antmicro/arty-mpw-tester/(notices)

Notices in the files:
parts and their libraries:
License: MIT
